ungood/graupel-1/docs/images/stratosphere.jpg

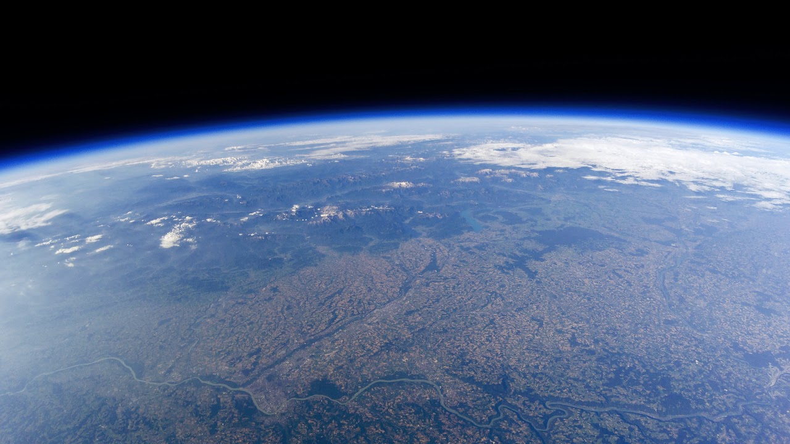
docs/images/stratosphere.jpg
