ungood/graupel-1/docs/images/mission-patch.png

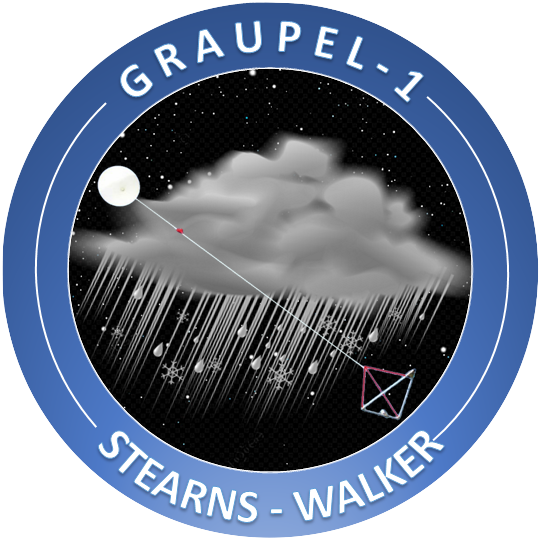
docs/images/mission-patch.png
