ungood/graupel-1/docs/diagrams/TrackerStateMachine.png

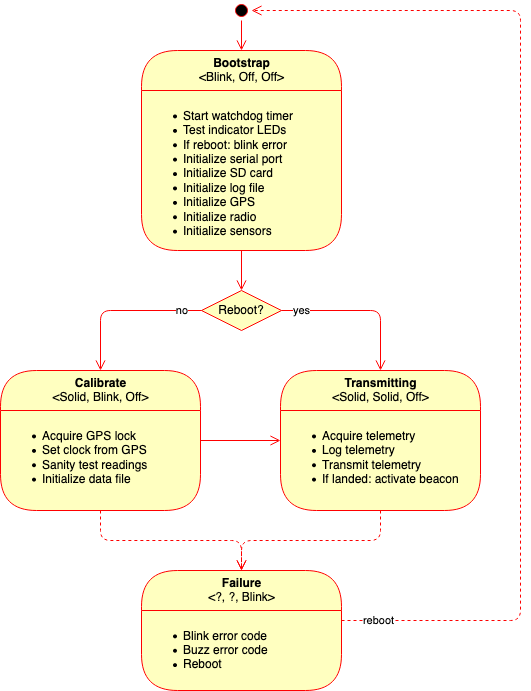
docs/diagrams/TrackerStateMachine.png
