ungood/graupel-1/docs/images/aprs-range.png

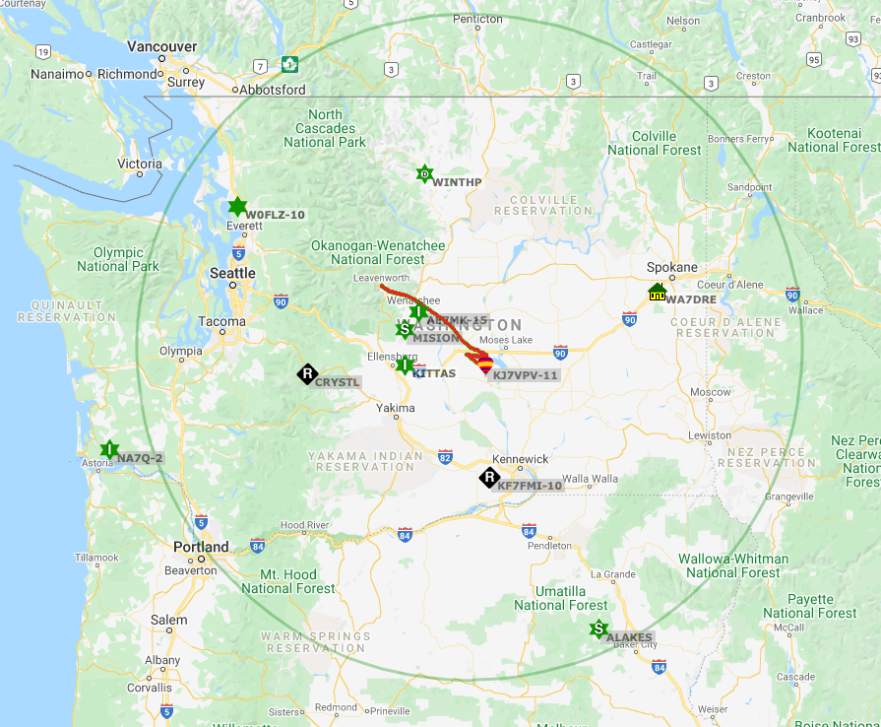
docs/images/aprs-range.png
