ungood/graupel-1/docs/images/go-pro.png

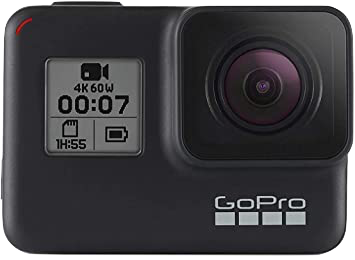
docs/images/go-pro.png
