ungood/graupel-1/docs/images/spot-trace.png

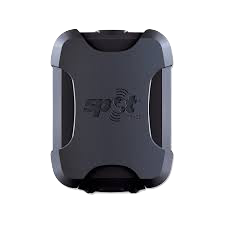
docs/images/spot-trace.png
