ungood/graupel-1/docs/diagrams/ComponentDiagram.png

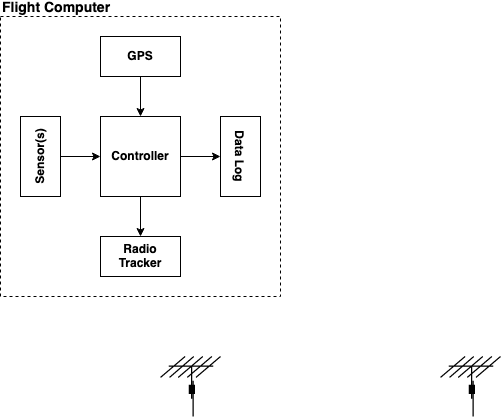
docs/diagrams/ComponentDiagram.png
