ungood/graupel-1/POST_MORTEM.md

Problems

1. GoPro did not record to burst altitude.
  1. Research why. Possibly either temperature or battery.
  1. Redundancy
1. Hard landing, loss of signal on landing.
  1. Research descent rate and coefficient of drag.
1. Frame stability
  1. Wobble
  1. Rotation
1. Better prediction and possible live tracking, prediction
  
Lessons learned

Battery performance in negative temperature
Value of live tracking: calculating rate of ascent, bearing from launch vehicle would be really nice.
DONT SPAM APRS
No need to record data faster than your GPS can output it...
Log raw data from sensors.
A radio beacon of some sort would be useful

There's a lot of different altitude/elevation fields we can get from GPS
https://gis.stackexchange.com/questions/174046/relation-between-geoidal-separation-and-antenna-altitude-in-gga-sentence

1. Calculating ascent rate, estimated time to burst
1. Calculating deviation from prediction
1. Running new predictions
1. Calculating descent rate, estimated time to land.

Other fun things to consider
* Geiger counter
* Accelerometer, Magnetometer
* Gas sensor
