ungood/graupel-1/(commit log)

2021-03-12 Unit tests and demos for indicator LEDs
2021-04-06 SD card shield modified for software SPI
2021-06-21 Adding raw data and processing diretory
    [raw-data.csv]
2021-07-01 Created flight path KML
    [clean-data.csv, standard-atmosphere.csv]
